ultrazohm/uz_per_remote_control/docs/some_wiring_notes.png

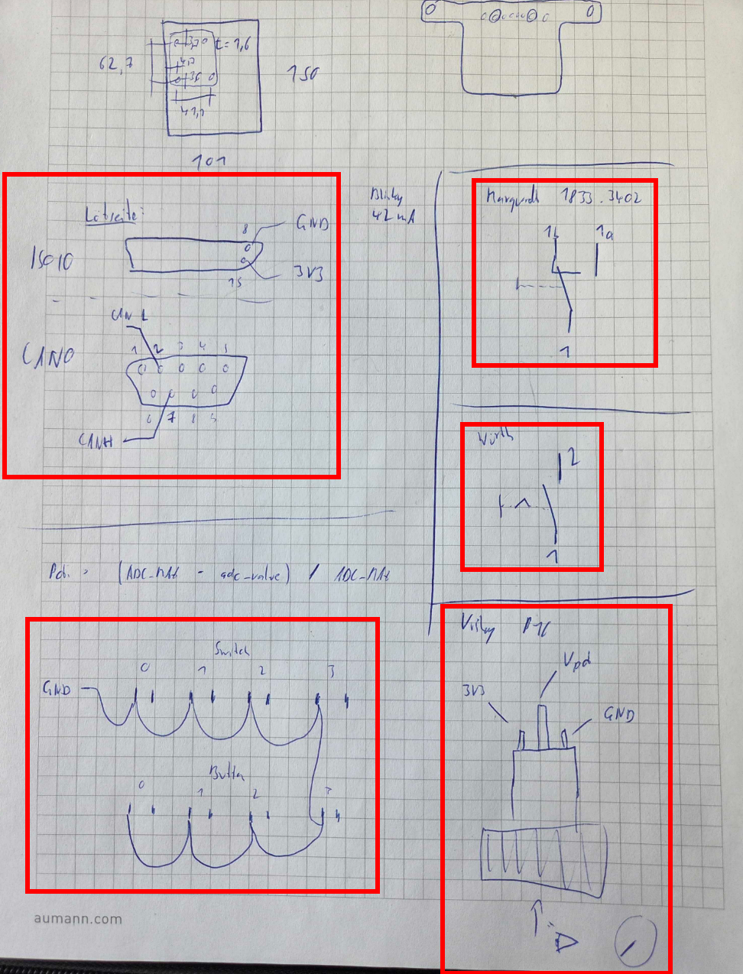
docs/some_wiring_notes.png
