ultrazohm/uz_per_remote_control/docs/1000044442.jpg

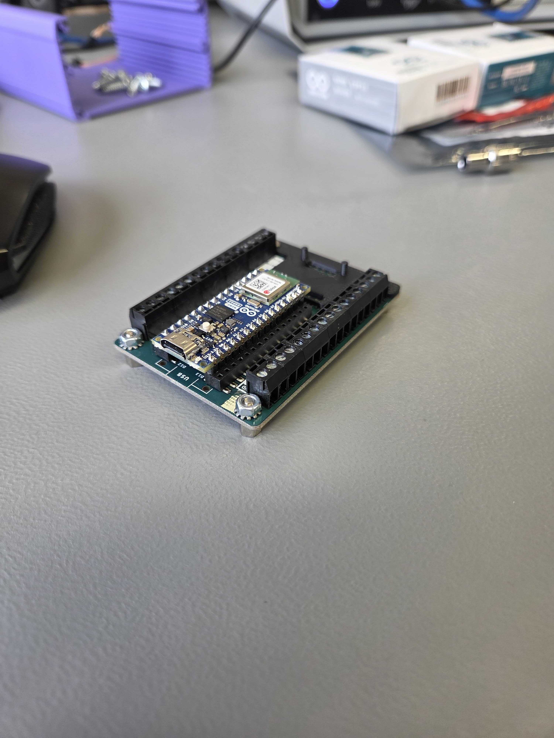
docs/1000044442.jpg
