ultrazohm/uz_per_remote_control/docs/konzept.pptx

4x Poti

Arduino Nano ESP32 mit Terminal Board

4x Wippschalter

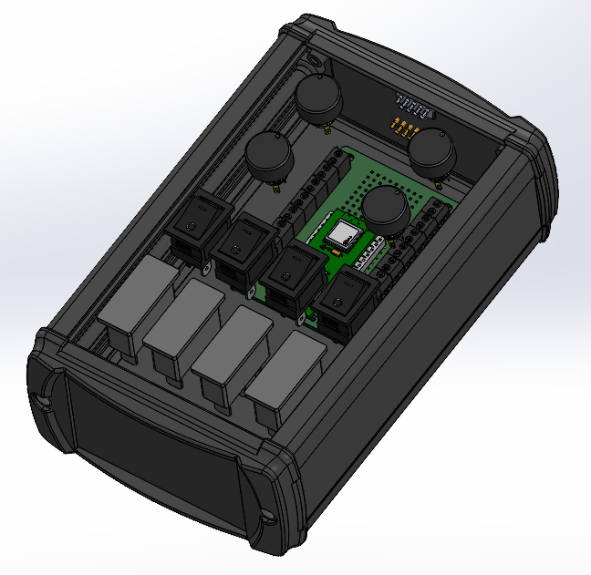
[picture p3: figure]
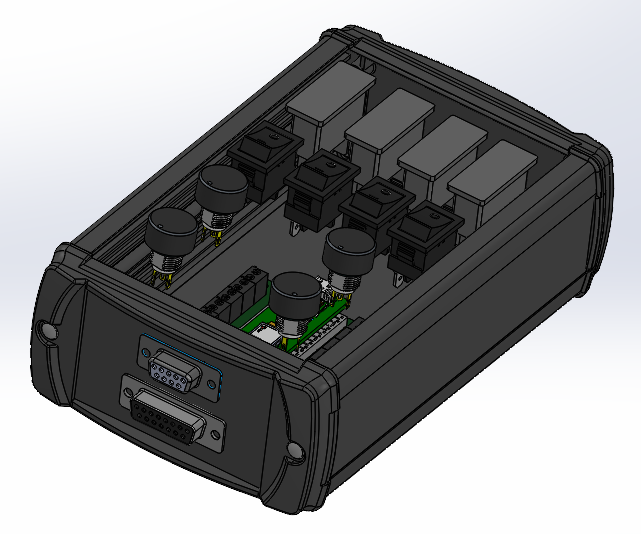
[picture p4: figure]

4x Wipptaster

D-Sub9:
CAN-Kommunikation mit dem UZ

52

150

106

D-Sub15: Versorgung über Frontpanel IO des UZ
