ultrazohm/uz_per_remote_control/docs/1000044508.jpg

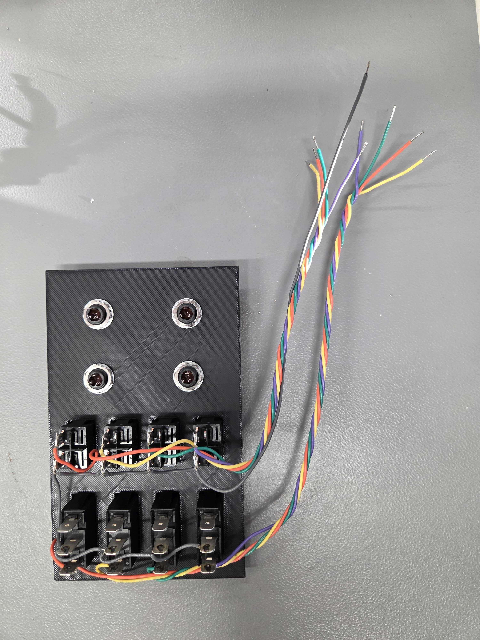
docs/1000044508.jpg
