ultrazohm/uz_per_remote_control/docs/remote_control_namings.png

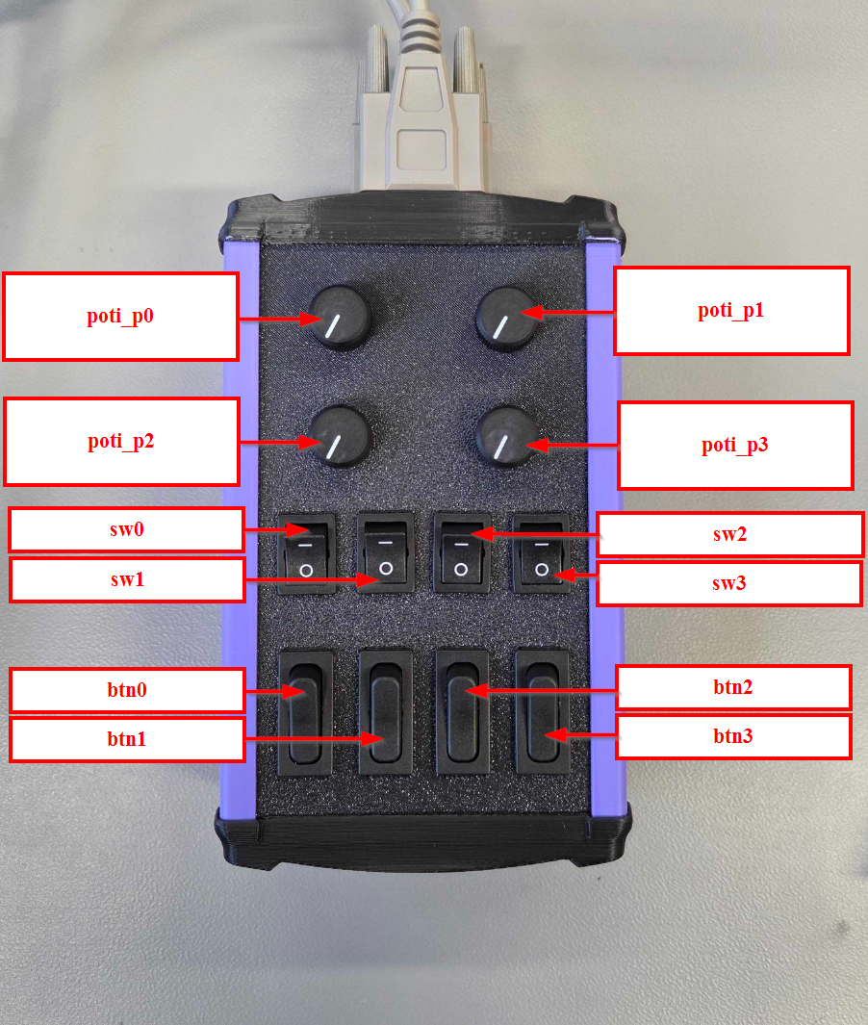
docs/remote_control_namings.png
