ultrazohm/uz_per_remote_control/docs/BOM.xlsx

Pos. | Description | Manufacturer Part Number | Amount | Link
1 | Arduino Nano ESP32 | ABX00083 | 1 | https://www.mouser.de/ProductDetail/Arduino/ABX00083?qs=ulEaXIWI0c8OkA6u7pnNRA%3D%3D
2 | Arduino Nano Screw Terminal Adapter | ASX00037 | 1 | https://www.mouser.de/ProductDetail/Arduino/ASX00037?qs=IPgv5n7u5QYSsQZSVD2HCg%3D%3D
3 | Adafruit CAN Pal TJA1051T/3 | 5708 | 1 | https://www.mouser.de/ProductDetail/Adafruit/5708?qs=mELouGlnn3dYblxi41jfAQ%3D%3D
4 | PCB Stand M3/5mm | 005.13.058 | 4 | https://www.ettinger.de/p/abstandsbolzen-messing-vernickelt-i-a-sw5x5-i-m3x2-5-a-m3x5-o.-freistich/005.13.058
5 | Nut M3 | 002.29.631 | 2 | https://www.ettinger.de/p/kombimutter-m3-stahl-8-verzinkt-zahnscheibe/002.29.631
6 | Screw ISO7045 M3x4 | 001.51.309 | 4 | https://www.ettinger.de/p/flachkopfschraube-iso7045-m3x4-stahl-rostfrei-a2-blank-torx-linsenkopf/001.51.309
7 | Self cutting screw 3.0x10 similar to | SHR Z KA30x10 | 4 | https://www.bopla.de/gehaeusetechnik/bocard/zubehoer-18/befestigungsschrauben-fuer-tragschienen-front-montage-und-trennplatten/shr-z-ka30x10
8 | Vishay Potentiometer | P16NP102MAB15F1 | 4 | https://www.mouser.de/ProductDetail/Vishay-Sfernice/P16NP102MAB15F1?qs=3Rah4i%252BhyCGDJQEmxeAQkg%3D%3D
9 | Würth Rocker Switch | 471001264143 | 4 | https://www.mouser.de/ProductDetail/Wurth-Elektronik/471001264143?qs=YCa%2FAAYMW03bZZ%252BoQThfXw%3D%3D
10 | Marquardt Momentary Rocker Switch | 1833.3402 | 4 | https://www.mouser.de/ProductDetail/Marquardt-Switches/1833.3402?qs=fgTiLP%252BNGFszNrjiUJ3png%3D%3D
11 | D-Sub15 | CN-DSUB15SKT0-000 | 1 | https://www.mouser.de/ProductDetail/Amphenol-Cables-on-Demand/CN-DSUB15SKT0-000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
12 | D-Sub9 | 302A10019X | 1 | https://www.mouser.de/ProductDetail/Amphenol-CONEC/302A10019X?qs=B9TV4DWH7gU%252BWqMf6Po%252BRA%3D%3D
13 | Mounting set for D-Sub | 160X10359X | 2 | https://www.mouser.de/ProductDetail/Amphenol-CONEC/160X10359X?qs=1A3x81zjaSxg%2Fs596t8lAQ%3D%3D
14 | Amphenol D-Sub15 cable male/male 10ft | CS-DSSMDB15MM-010 | 1 | https://www.mouser.de/ProductDetail/Amphenol-Cables-on-Demand/CS-DSSMDB15MM-010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
15 | Amphenol D-Sub9 cable male/male 10ft | CS-DSSMDB9MM0-010 | 1 | https://www.mouser.de/ProductDetail/Amphenol-Cables-on-Demand/CS-DSSMDB9MM0-010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
