ultrazohm/uz_per_remote_control/mechanics/parts/marquardt_18333402_01_K.pdf

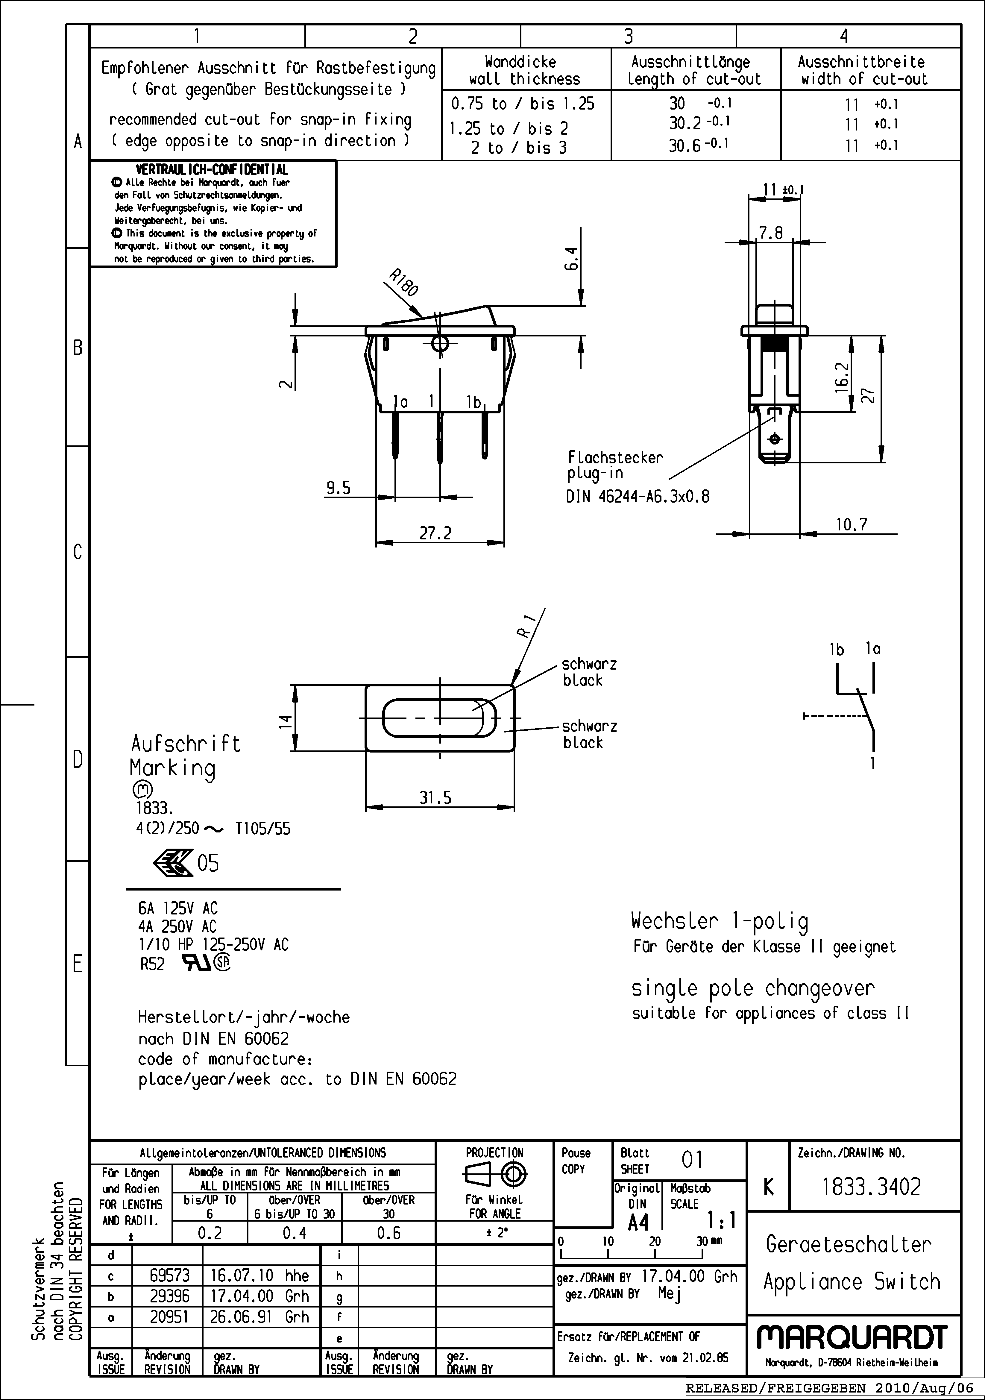
[picture p13: page 1]
