ultrazohm/uz_per_remote_control/mechanics/parts/ELD_1050_part_dsub.SLDPRT

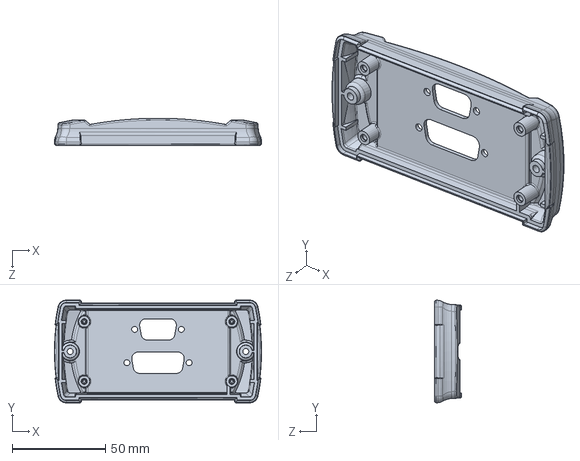
[picture p14: CAD file, 2026-01-13]
mechanics/parts/ELD_1050_part_dsub.SLDPRT
110.8 x 55.0 x 14.7 mm
