ultrazohm/uz_per_remote_control/mechanics/parts/pcb_carrier.SLDPRT

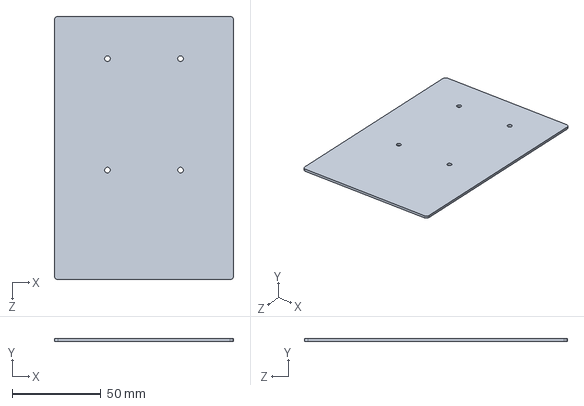
[picture p15: CAD file, 2026-01-13]
mechanics/parts/pcb_carrier.SLDPRT
101.0 x 1.60 x 148.0 mm
