ultrazohm/uz_per_remote_control/mechanics/parts/CN-DSUB15SKT0-000.stp

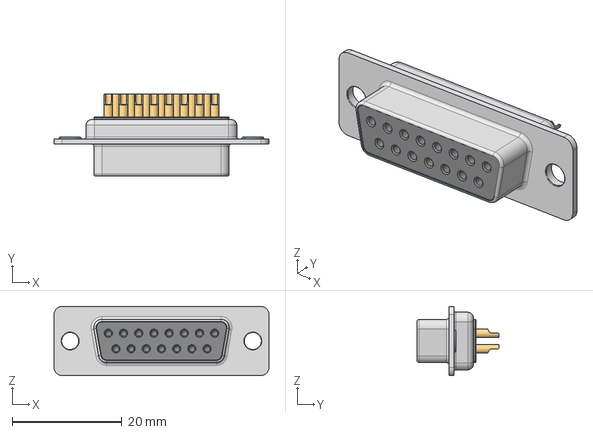
[picture p16: CAD file, 2026-01-13]
mechanics/parts/CN-DSUB15SKT0-000.stp
39.2 x 15.0 x 12.6 mm
