ultrazohm/uz_per_remote_control/mechanics/parts/can_pcb_carrier.SLDPRT

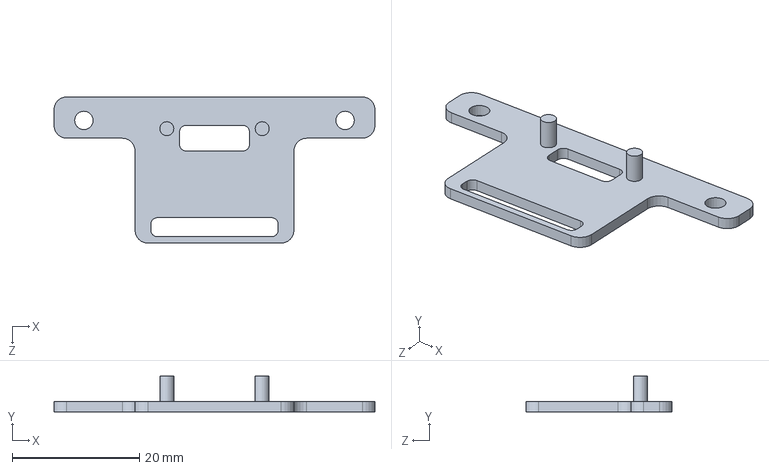
[picture p17: CAD file, 2026-01-13]
mechanics/parts/can_pcb_carrier.SLDPRT
50.5 x 5.60 x 23.0 mm
