ultrazohm/uz_per_remote_control/mechanics/parts/frontplatte.SLDPRT

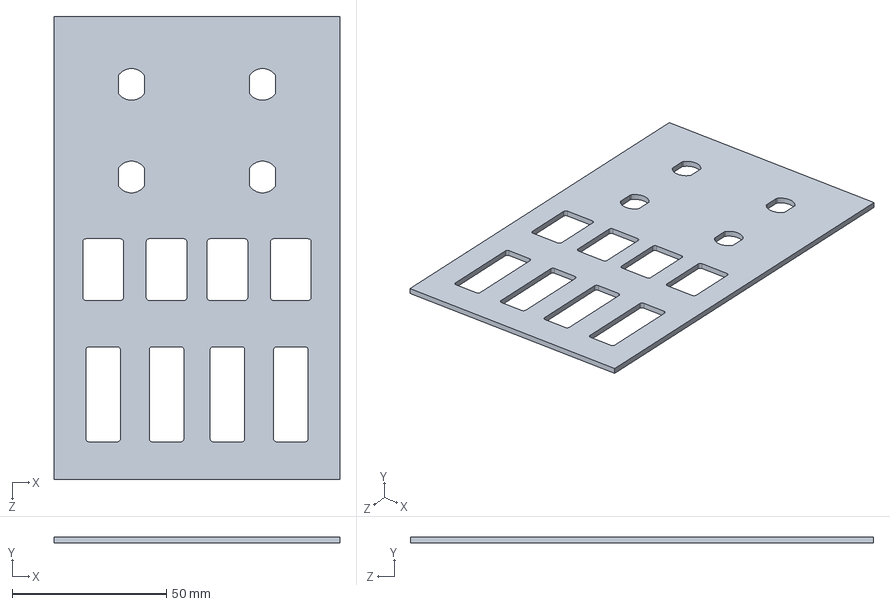
[picture p18: CAD file, 2026-01-13]
mechanics/parts/frontplatte.SLDPRT
92.5 x 2.00 x 150.0 mm
