ultrazohm/uz_per_remote_control/mechanics/parts/NANO_ESP32.step

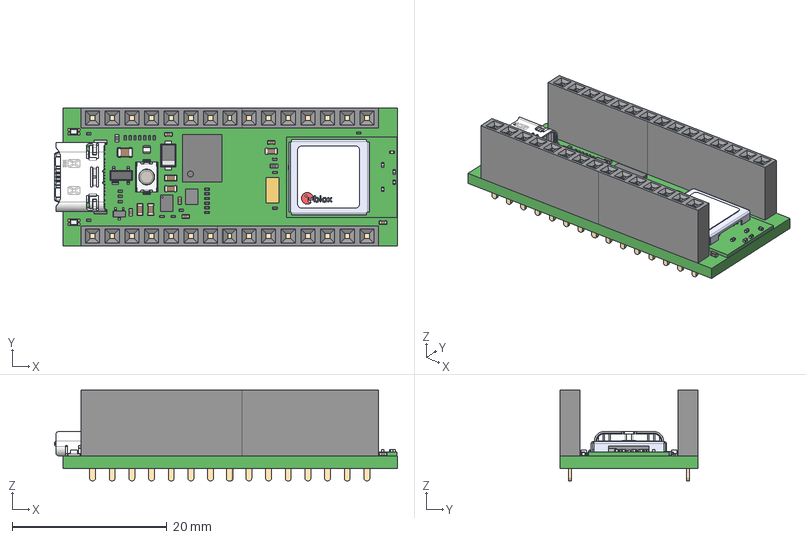
[picture p19: CAD file, 2026-01-13]
mechanics/parts/NANO_ESP32.step
44.3 x 17.8 x 11.7 mm
RES-0201 x 21
CAP-0402 x 6
Extruded x 90
CAP-0201 x 4
pins
logo
label_8x8
logo_x_4mm
logo_o_4mm
logo_l_4mm
logo_b_4mm
logo_u_4mm
MAYA_W1_Shield_UBXH04-0000683
RES-0402 x 2
Thermal_Shape
SOT-523
HSMx-190 x 2
CAP-0603 x 5
lead x 2
SMLP34RGB
Header _Fem_1X8 x 4
PTS820J20KSMTRLFS
CX90B-16P_3D
PRTR5V0U2X
CAP-0805
