ultrazohm/uz_per_remote_control/mechanics/parts/User Library-PA16 Pot.sldprt

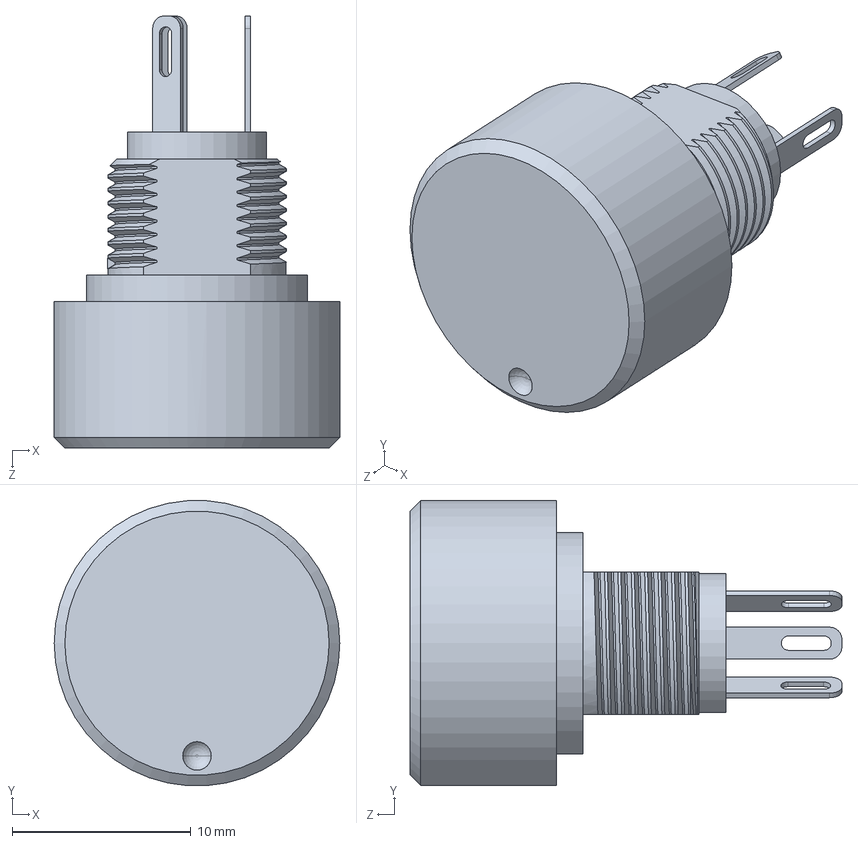
[picture p20: CAD file, 2026-01-13]
mechanics/parts/User Library-PA16 Pot.sldprt
16.0 x 16.0 x 24.2 mm
