ultrazohm/uz_per_remote_control/mechanics/parts/302A10019X.stp

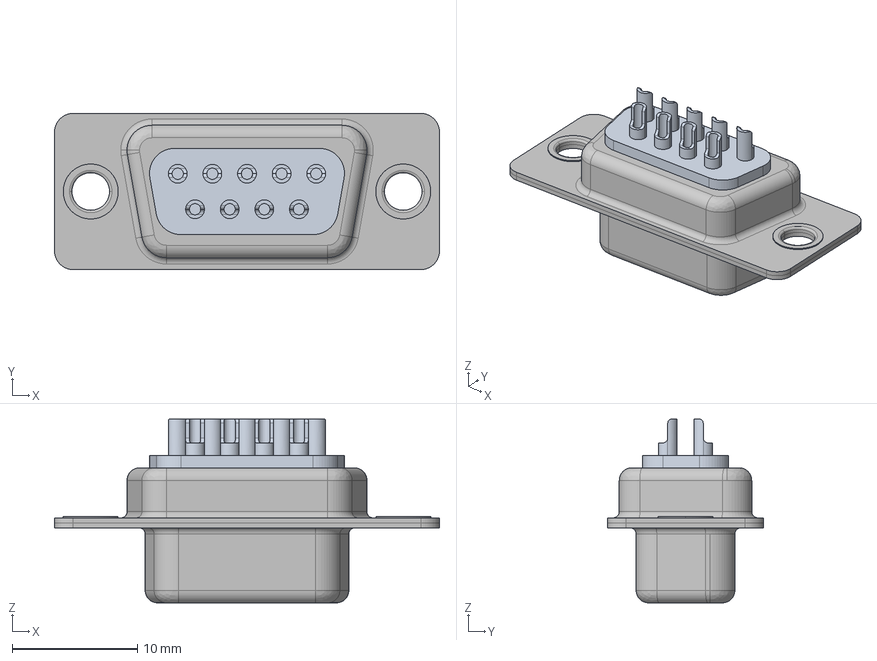
[picture p21: CAD file, 2026-01-13]
mechanics/parts/302A10019X.stp
30.8 x 12.5 x 14.7 mm
