ultrazohm/uz_per_remote_control/mechanics/parts/471001264143_prt.SLDPRT

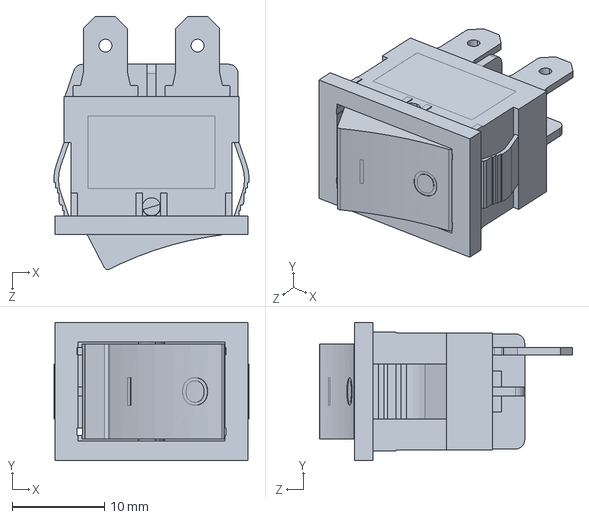
[picture p22: CAD file, 2026-01-13]
mechanics/parts/471001264143_prt.SLDPRT
21.2 x 15.0 x 27.5 mm
