ultrazohm/uz_per_remote_control/mechanics/parts/18333402_dummy.SLDPRT

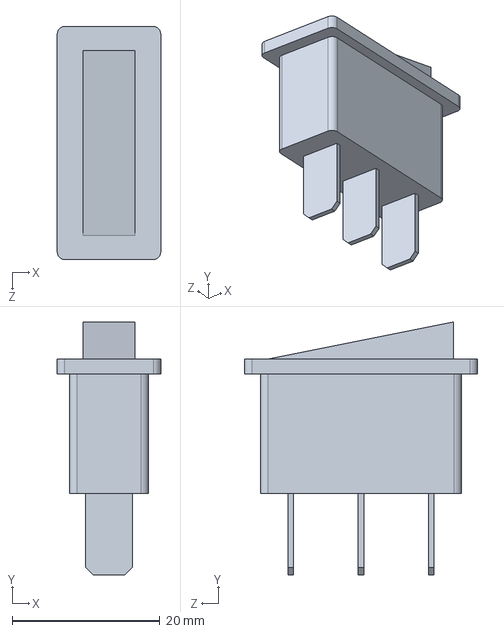
[picture p23: CAD file, 2026-01-13]
mechanics/parts/18333402_dummy.SLDPRT
14.0 x 34.2 x 31.5 mm
