ultrazohm/uz_per_remote_control/mechanics/parts/Nano Screw Terminal Adapter.step

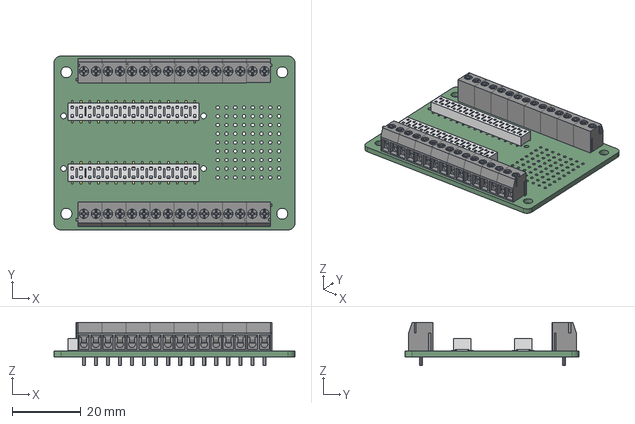
[picture p24: CAD file, 2026-01-13]
mechanics/parts/Nano Screw Terminal Adapter.step
70.0 x 50.5 x 12.5 mm
