ultrazohm/uz_per_remote_control/mechanics/parts/83057150.S6_ELPU-1050-0150-D_part.SLDPRT

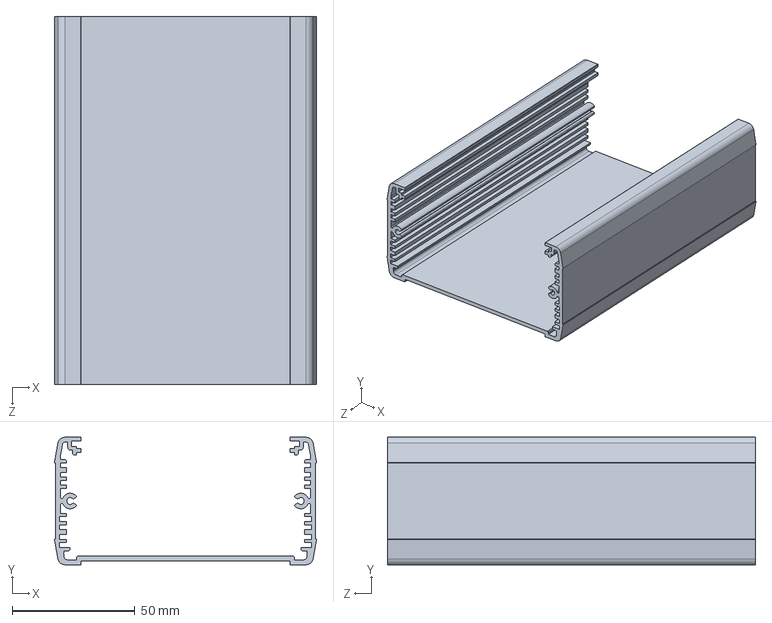
[picture p25: CAD file, 2026-01-13]
mechanics/parts/83057150.S6_ELPU-1050-0150-D_part.SLDPRT
106.8 x 52.0 x 150.0 mm
