ultrazohm/uz_per_remote_control/mechanics/parts/83057150.S6_ELPU-1050-0150-D.stp

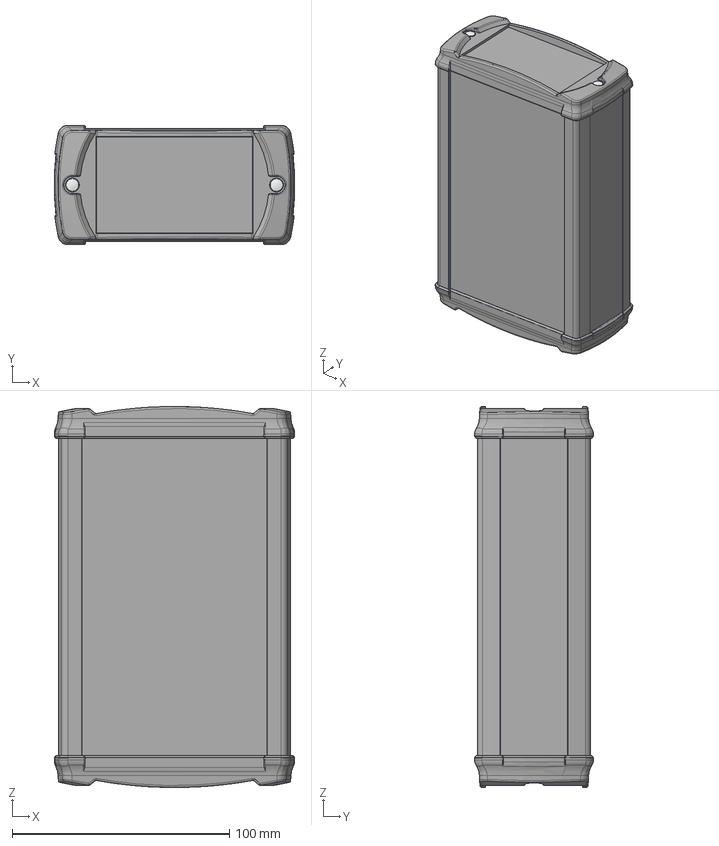
[picture p26: CAD file, 2026-01-13]
mechanics/parts/83057150.S6_ELPU-1050-0150-D.stp
110.7 x 55.0 x 175.4 mm
ELPU 1050_1009053_3DSYM
ELD 1050_1009057_3D x 2
SHR Z KA30X10 WN 1412 MG_3DSYM x 4
1003804_3Dsym x 4
