ultrazohm/uz_per_remote_control/mechanics/parts/83058150_ELPU-1050-0150-FP2-G.dxf

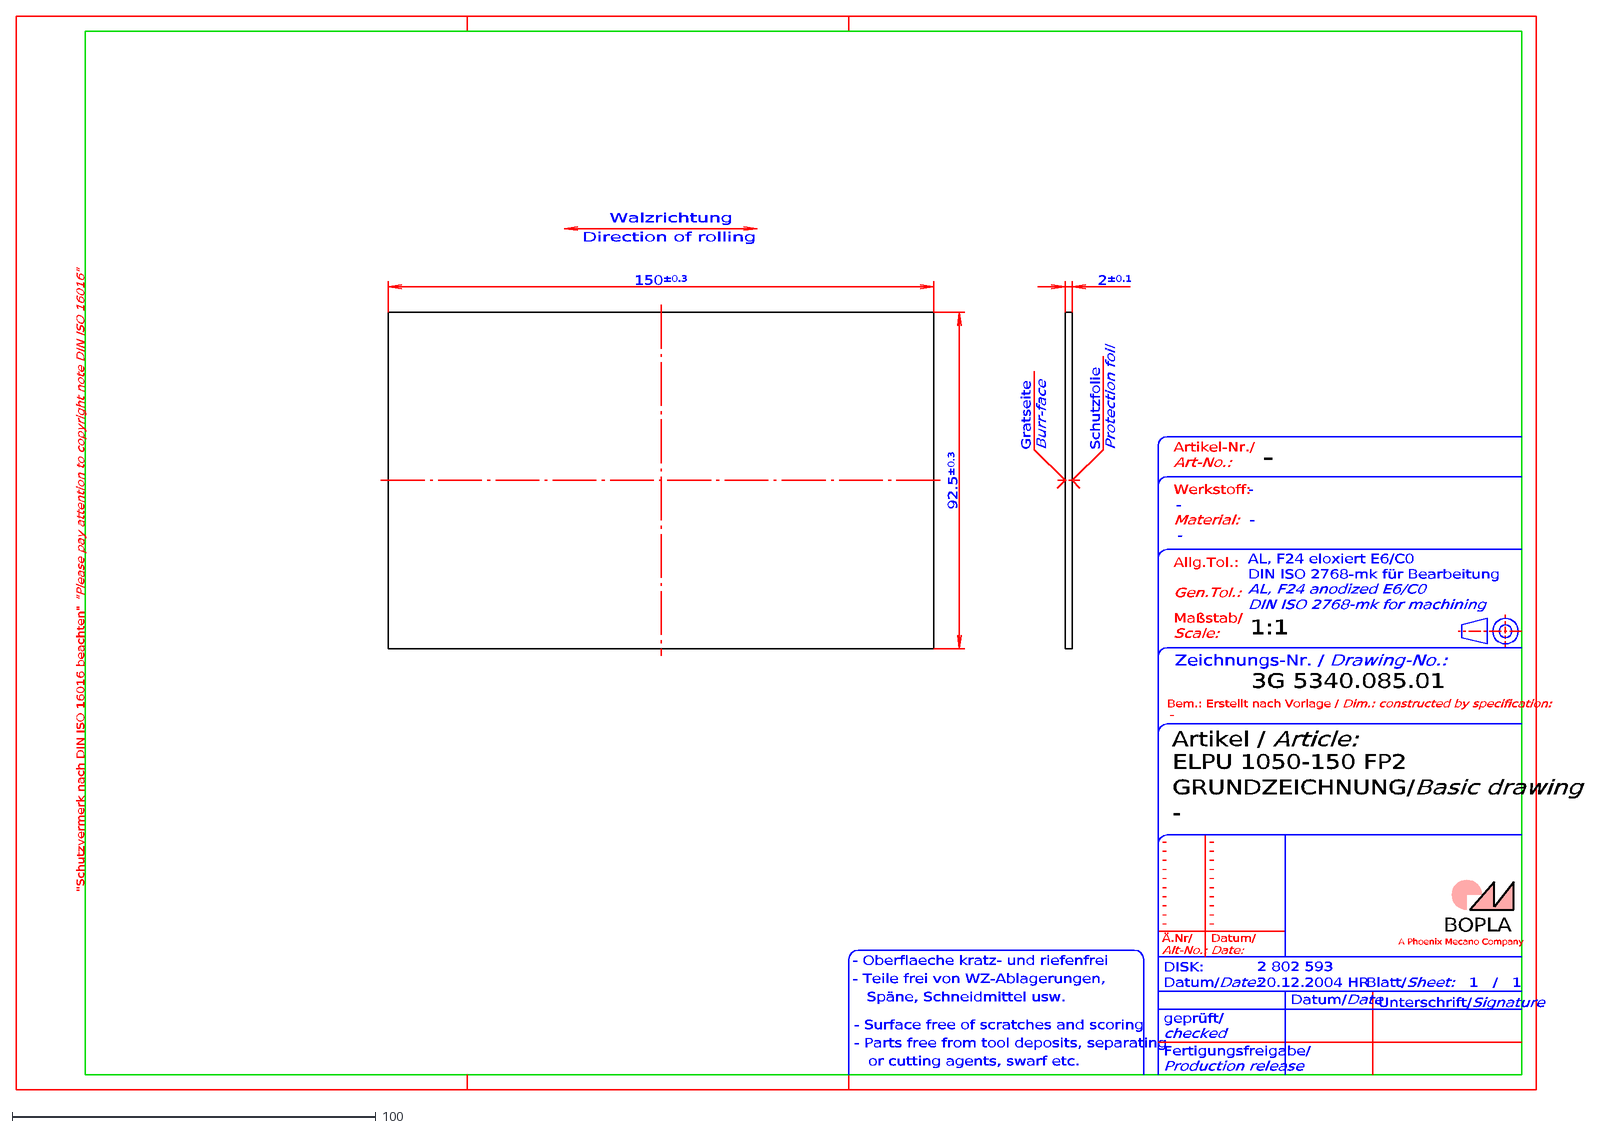
[picture p27: CAD file, 2026-01-13]
mechanics/parts/83058150_ELPU-1050-0150-FP2-G.dxf
92.5±0.3
2±0.1
150±0.3
"Schutzvermerk nach DIN ISO 16016 beachten" "Please pay attention to copyright note DIN ISO 16016"
Direction of rolling
Walzrichtung
Schutzfolie Protection foil
Gratseite Burr-face
- Surface free of scratches and scoring
- Parts free from tool deposits, separating
or cutting agents, swarf etc.
- Oberflaeche kratz- und riefenfrei
- Teile frei von WZ-Ablagerungen,
Späne, Schneidmittel usw.
1:1
Maßstab/ Scale:
Zeichnungs-Nr. / Drawing-No.:
3G 5340.085.01
Datum/ Date:
Ä.Nr/ Alt-No.:
DISK:
Datum/Date:
-
Blatt/Sheet: 1 / 1
Datum/Date
Unterschrift/Signature
geprüft/ checked
Fertigungsfreigabe/ Production release
2 802 593
20.12.2004 HR
Bem.: Erstellt nach Vorlage / Dim.: constructed by specification:
Allg.Tol.:
AL, F24 eloxiert E6/C0
DIN ISO 2768-mk für Bearbeitung
DIN ISO 2768-mk for machining
AL, F24 anodized E6/C0
Gen.Tol.:
Werkstoff:
Material:
Artikel-Nr./ Art-No.:
BOPLA
A Phoenix Mecano Company
Artikel / Article:
ELPU 1050-150 FP2
GRUNDZEICHNUNG/Basic drawing
