ultrazohm/uz_per_remote_control/mechanics/assembly/cable_remote_assembly.SLDASM

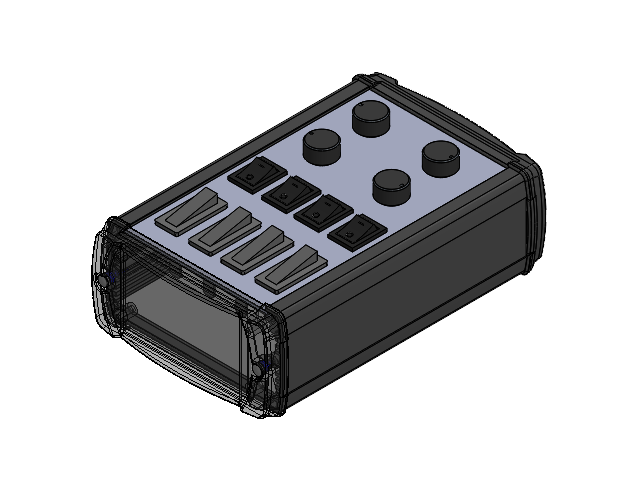
[picture p28: CAD file, 2026-01-13]
mechanics/assembly/cable_remote_assembly.SLDASM
ELPU 1050_1009053_3DSYM.stp
ELD 1050_1009057_3D.stp
SHR Z KA30X10 WN 1412 MG_3DSYM.stp x 4
1003804_3Dsym.stp x 4
User Library-PA16 Pot x 4
471001264143_prt x 4
302A10019X
CN-DSUB15SKT0-000
NANO_ESP32
Nano Screw Terminal Adapter
18333402_dummy x 4
frontplatte
pcb_carrier
can_pcb_carrier
ELD_1050_part_dsub
