ultrazohm/uz_per_remote_control/(list of files, cad)

Other CAD files:
mechanics/parts/ELD_1050_part.SLDPRT
mechanics/parts/Standard-Fraeskonturen_Standard_Openings.dxf
mechanics/parts/471001264143.stp
mechanics/parts/302A10019X.SLDPRT
mechanics/parts/471001264143.SLDASM
mechanics/parts/83057150.S6_ELPU-1050-0150-D.SLDASM
mechanics/parts/CN-DSUB15SKT0-000.SLDPRT
mechanics/parts/NANO_ESP32.SLDPRT
mechanics/parts/Nano Screw Terminal Adapter.SLDPRT
mechanics/parts/stl/83057150.S6_ELPU-1050-0150-D_part.STL
mechanics/parts/stl/ELD_1050_part.STL
mechanics/parts/stl/ELD_1050_part_dsub.STL
mechanics/parts/stl/can_pcb_carrier.STL
mechanics/parts/stl/frontplatte.STL
mechanics/parts/stl/pcb_carrier.STL
