ultrazohm/uz_per_remote_control/(list of files, drawings)

Other design files:
mechanics/parts/ASX00037-cad-files/Nano_Screw_Terminal_Adapter/Nano Screw Terminal Adapter.PcbDoc
mechanics/parts/ASX00037-cad-files/Nano_Screw_Terminal_Adapter/Nano Screw Terminal Adapter.SchDoc
