ultrazohm/uz_per_remote_control/(commit log)

2026-01-13 initial commit for saving all data for the first version of a cable remote control for the UZ
    [18333402_dummy.SLDPRT, 302A10019X.SLDPRT, 302A10019X.stp, 471001264143.SLDASM, 471001264143.stp, 471001264143_prt.SLDPRT, 83057150.S6_ELPU-1050-0150-D.SLDASM, 83057150.S6_ELPU-1050-0150-D.stp]
2026-01-13 removed just one file
    [print_complete_housing.3mf]
2026-01-13 added BOM and some wiring notes
    [BOM.xlsx]
2026-01-15 some pics from assembly and soldering
